K-M/ps5-wireless-headphones/hardware/README.md

# Hardware

Printable STLs and the editable Fusion 360 sources for both enclosures.

## Files

| Folder | Contents |
|---|---|
| [`stl/headset-modules/`](stl/headset-modules/) | One STL per part, plus `all-parts_plate.stl` (the original export, all parts laid out together) |
| [`stl/transmitter/`](stl/transmitter/) | `case.stl` and `lid.stl` for the Waveshare ESP32-S3-Pico, plus the combined plate |
| [`fusion/`](fusion/) | `headset-modules.f3d` and `transmitter.f3d`. Edit these to fit other headbands or boards. |

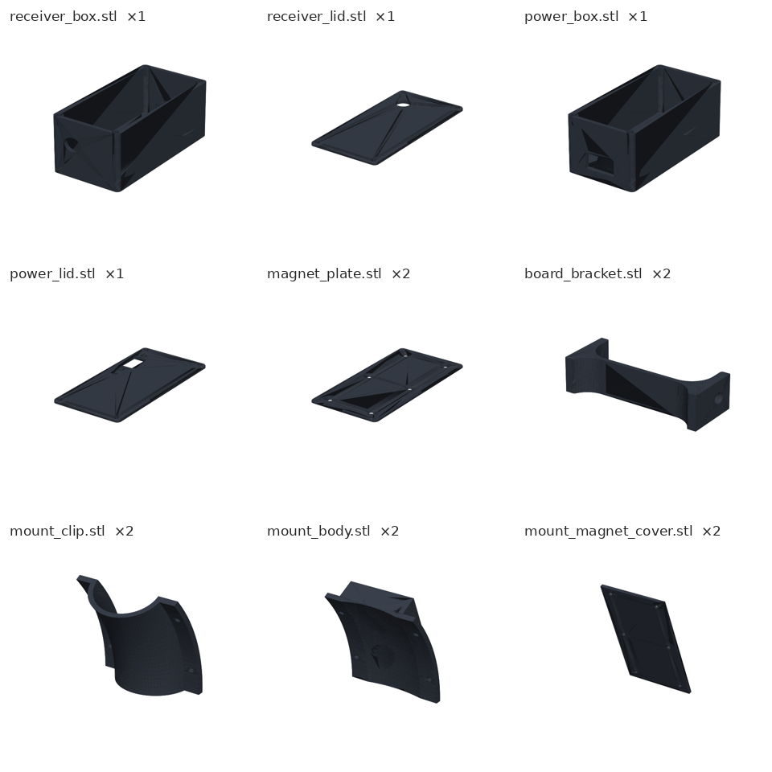
[picture p6: hardware/headset-parts.png]
Headset module parts


| Part | Qty | Notes |
|---|---|---|
| `receiver_box` | 1 | Houses the ESP32-S3-Nano (the box with the round side hole) |
| `receiver_lid` | 1 | Lid with the encoder-knob hole |
| `power_box` | 1 | Houses the LiPo, HW-107, HW-106, switch and LED |
| `power_lid` | 1 | Lid with the slide-switch cutout |
| `magnet_plate` | 2 | One per box, 6 × M2 screws; it attaches the box to the headband mount |
| `board_bracket` | 2 | Holds the ESP32 and HW-106 boards in place by sitting in the pin-header grooves (neither board has mounting holes) |
| `mount_clip`, `mount_body`, `mount_magnet_cover` | 2 each | Curved headband mount, one per module (see below) |

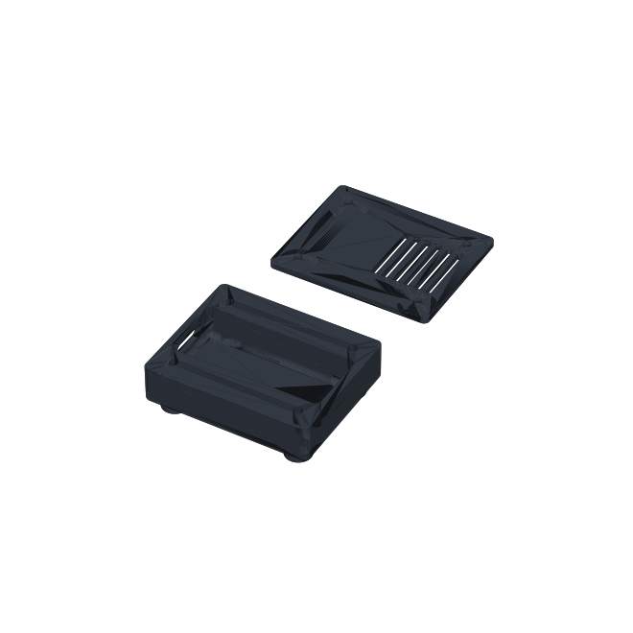
[picture p7: hardware/transmitter-parts.png]
Transmitter case and lid


Print in PLA or PETG at 0.2 mm layers. No supports are needed for the lids and plates. The boxes and the curved mount parts may need supports, depending on how you orient them.

## Layout

There are two printed boxes, one on each side of the headband. Each box sits on a curved mount that clips to the band and holds it by magnets.

| Module | Contents | Controls / ports |
|---|---|---|
| Power | LiPo, HW-107 charger, HW-106 boost, DPDT switch, LED, USB-C breakout | LED window, slide switch, USB-C (charging), 5 V out to the receiver |
| Receiver | ESP32-S3-Nano, rotary encoder, USB audio dongle | Volume knob, 3.5 mm out, USB |

Splitting the build like this balances the weight on the headband and keeps the boost converter away from the radio and audio parts.

| | | |
|---|---|---|
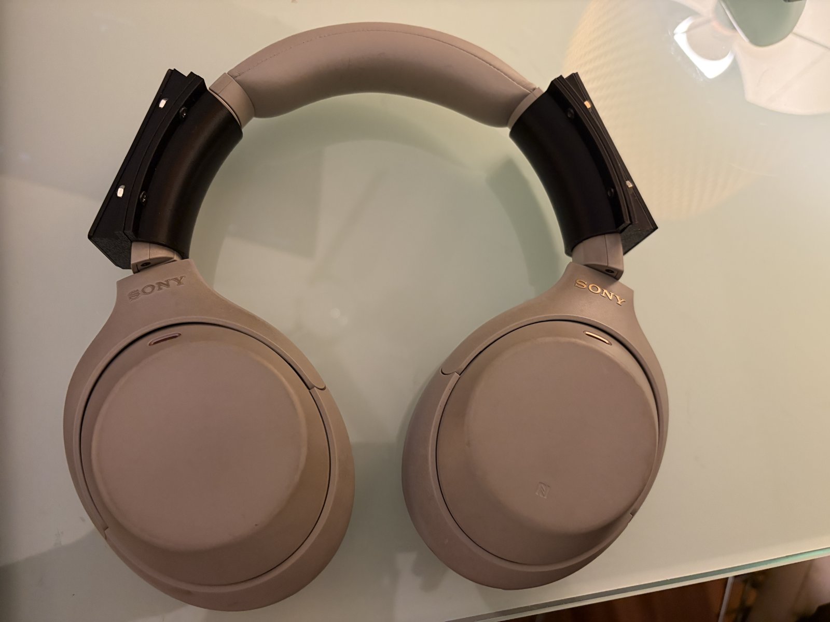
[picture p8: images/mounts-on-headband.jpg]
Curved mounts on the headband
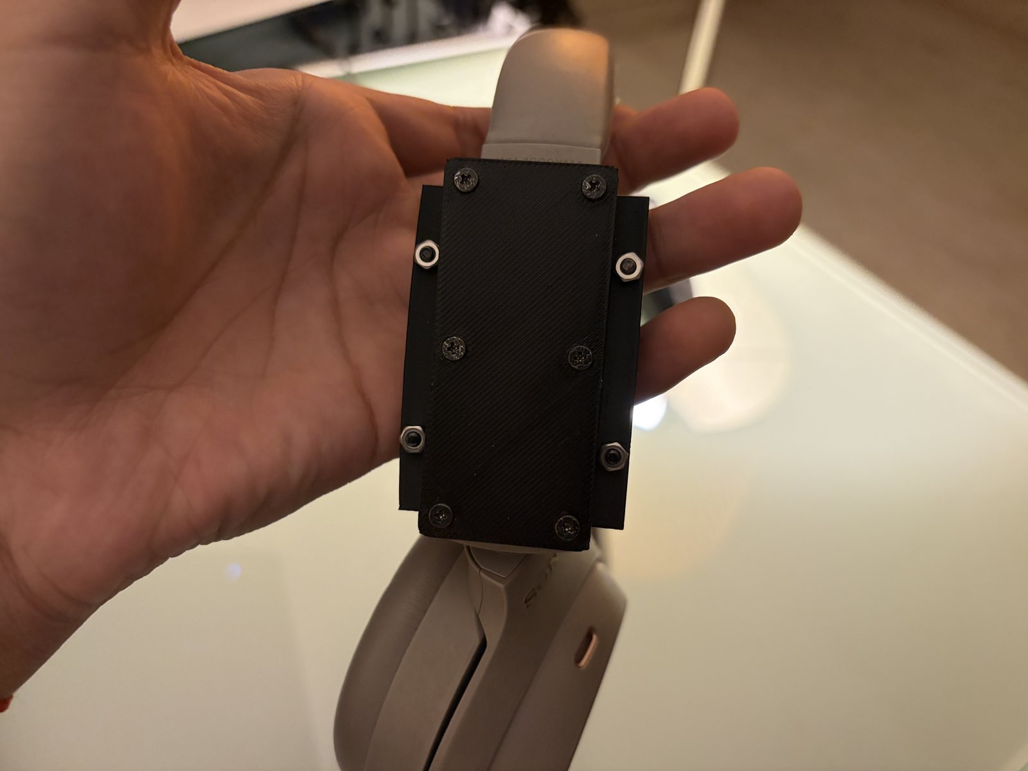
[picture p9: images/magnet-mount.jpg]
Magnet mount plate
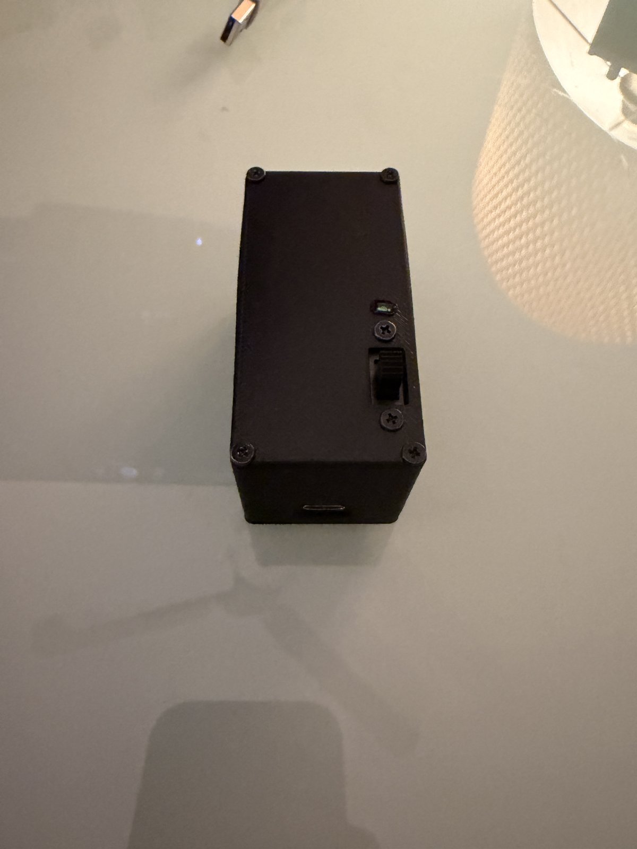
[picture p10: images/power-module-top.jpg]
Power module top: LED and switch
|  |  |  |
| Curved mounts, modules removed | Magnet mount plate | Power module: LED, switch, USB-C |
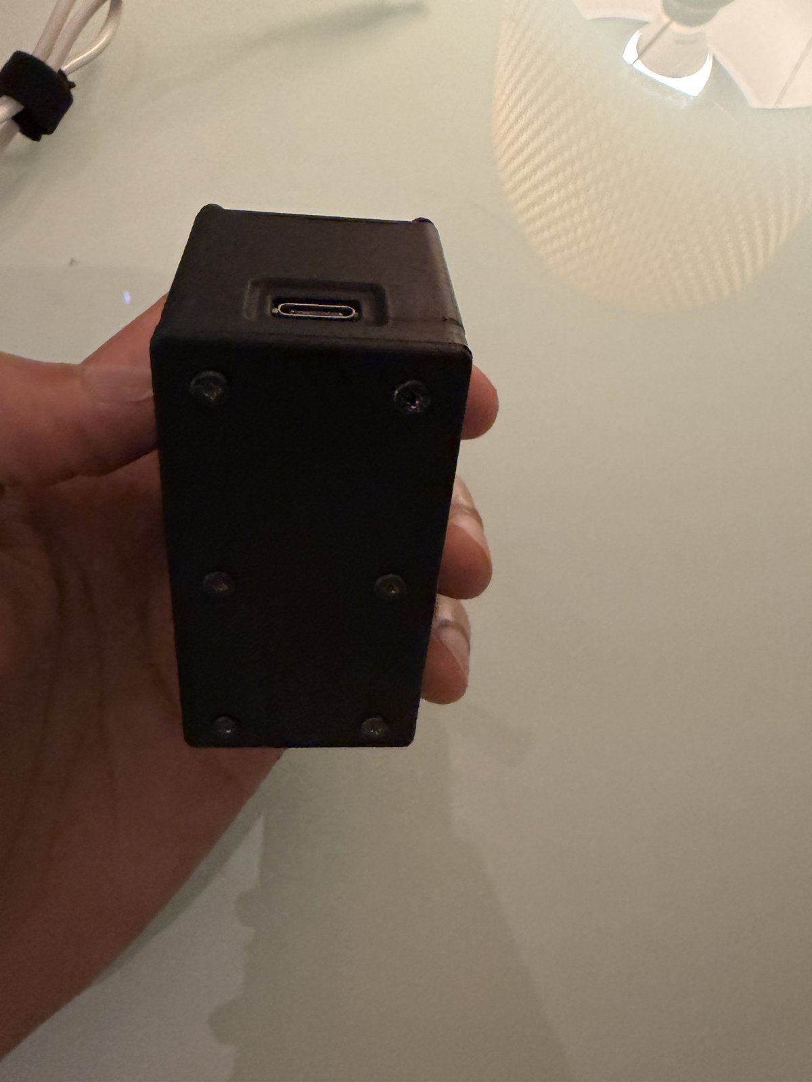
[picture p11: images/power-module-back.jpg]
Power module back
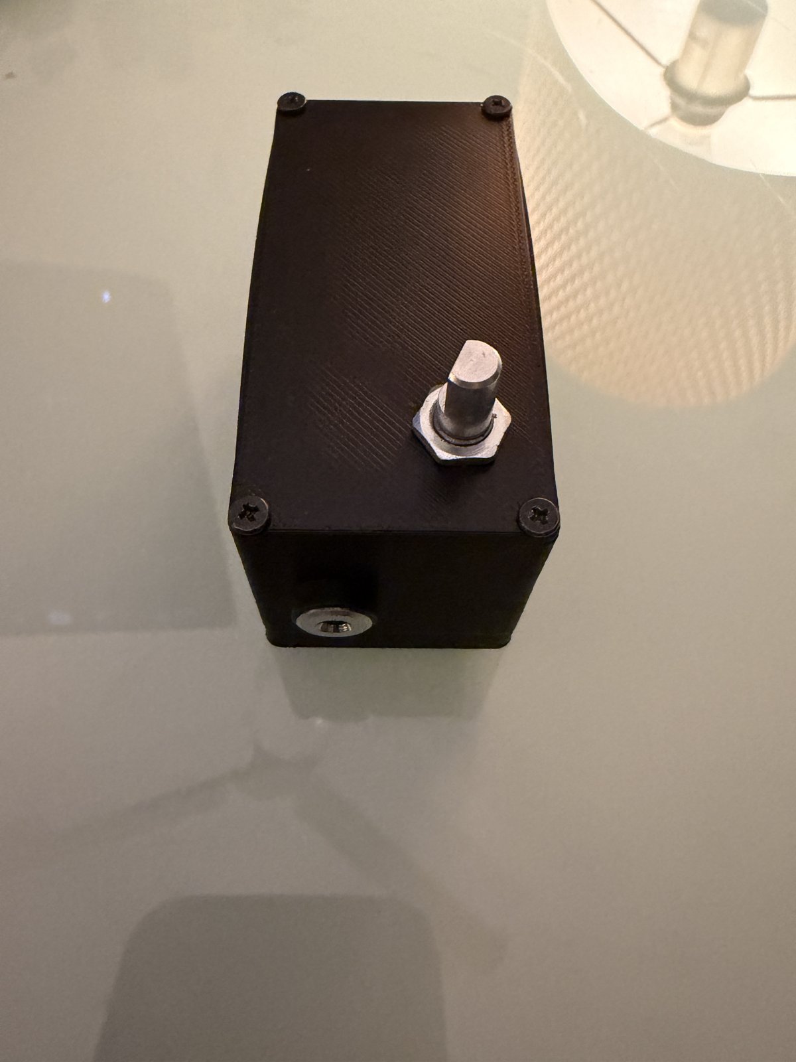
[picture p12: images/receiver-encoder-jack.jpg]
Receiver: knob and 3.5 mm jack
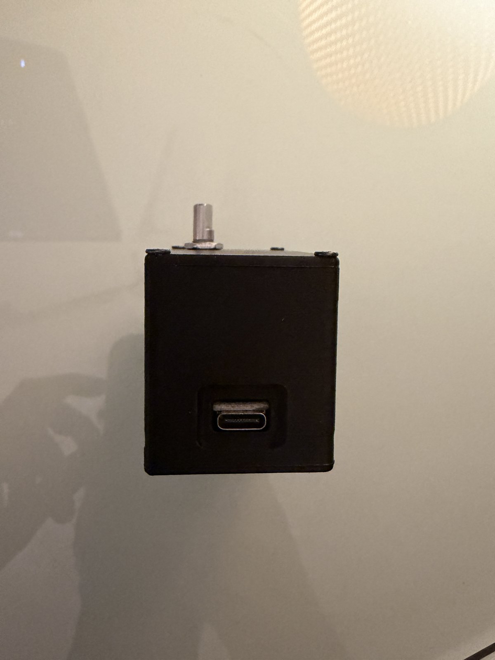
[picture p13: images/usb-c-end.jpg]
Module end with USB-C
|  |  |  |
| Power module lid, 6 × M2 screws | Receiver: volume knob and 3.5 mm | Module end, USB-C |

## Curved headband mount (Fusion 360)

The WH-1000XM4 headband's top surface has a radius of about **99.33 mm**. The mount is a 2D cross-section revolved around an axis at that radius:

1. Sketch the cross-section in the front plane: the magnet cover, the body, and the clip that wraps under the band.
2. Draw a horizontal construction line **99.33 mm below the top contact point**, outside every profile. If the axis touches a profile, Fusion reports that it "crosses the axis".
3. Revolve the profile around that line by **angle = length ÷ 99.33 × 57.3°**. For example, a 60 mm part needs 34.61°. Use the same angle for every part of the mount so they line up.

Revolve method

To measure your own headband's radius, trace its curve on paper. Then measure a chord *c* and the height *h* of the arc above the chord, and use **R = c²/(8h) + h/2**.

## Notes

- **Screws:** M2–M2.5 self-tapping into printed pilot holes. Use 1.6 mm pilot holes for M2 and 2.0 mm for M2.5.
- **Magnets:** keep them at least about 1 cm from the ESP32's antenna and the boost converter's inductor. If there's no room, use a thin steel plate as a shield behind the magnet.
- **Capacitors:** fit the 470 µF capacitor at the Nano's VBUS pin, not at the boost output. The boost and the Nano are in different modules, so the capacitor must sit at the load end of the cable.
