K-M/ps5-wireless-headphones/images/usb-a-end.jpg

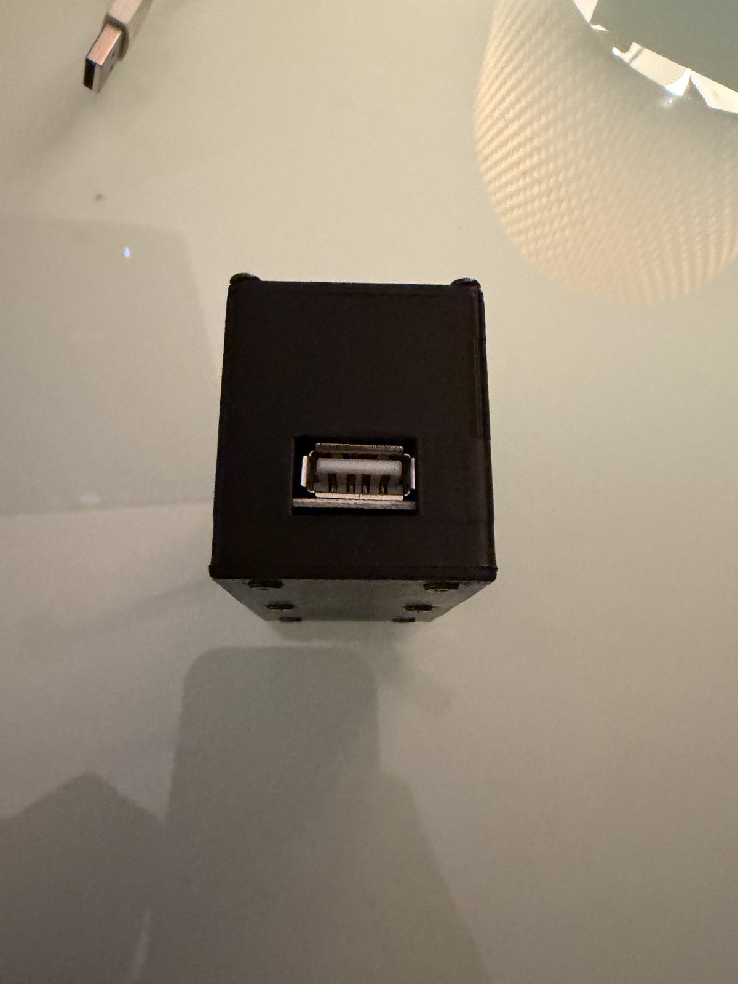
images/usb-a-end.jpg
