K-M/ps5-wireless-headphones/hardware/stl/headset-modules/mount_body.stl

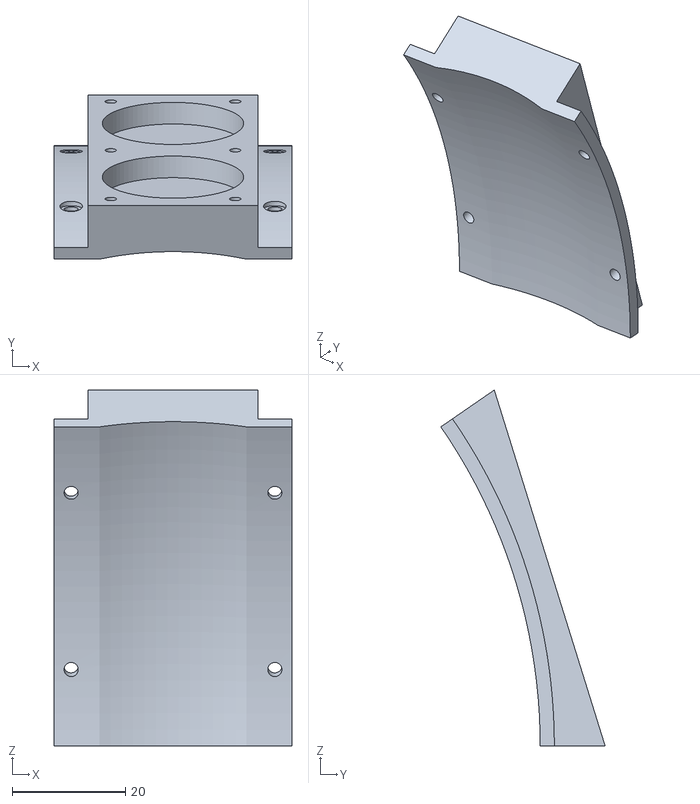
[picture p15: CAD file, 2026-10-23]
hardware/stl/headset-modules/mount_body.stl
42.0 x 29.0 x 62.9
