K-M/ps5-wireless-headphones/hardware/stl/transmitter/lid.stl

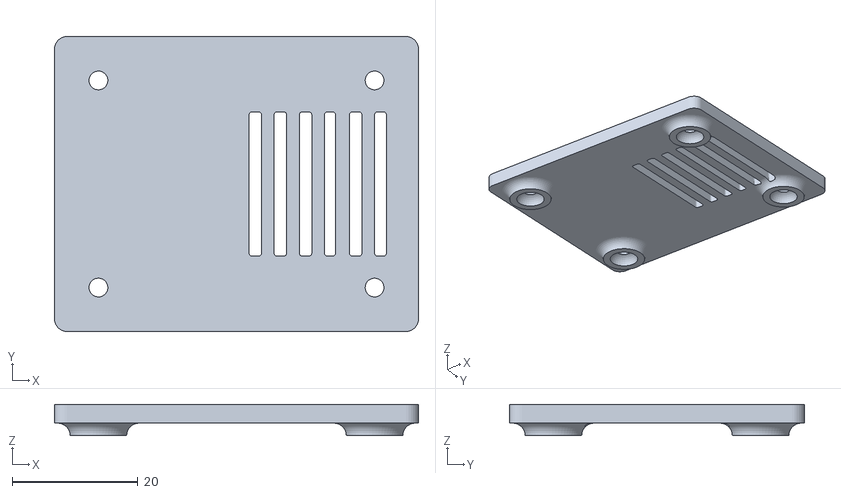
[picture p16: CAD file, 2026-10-23]
hardware/stl/transmitter/lid.stl
58.0 x 47.0 x 5.00
