K-M/ps5-wireless-headphones/hardware/stl/headset-modules/receiver_box.stl

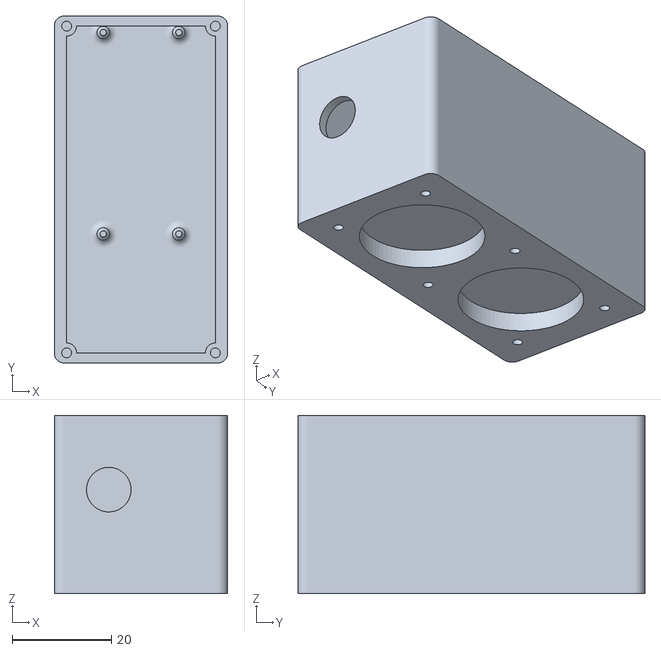
[picture p17: CAD file, 2026-10-23]
hardware/stl/headset-modules/receiver_box.stl
35.0 x 70.0 x 36.0
