K-M/ps5-wireless-headphones/hardware/stl/transmitter/case.stl

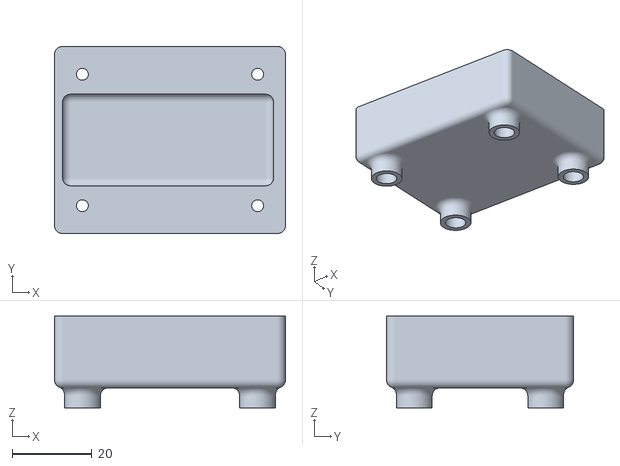
[picture p18: CAD file, 2026-10-23]
hardware/stl/transmitter/case.stl
58.0 x 47.0 x 23.0
