K-M/ps5-wireless-headphones/hardware/stl/headset-modules/mount_magnet_cover.stl

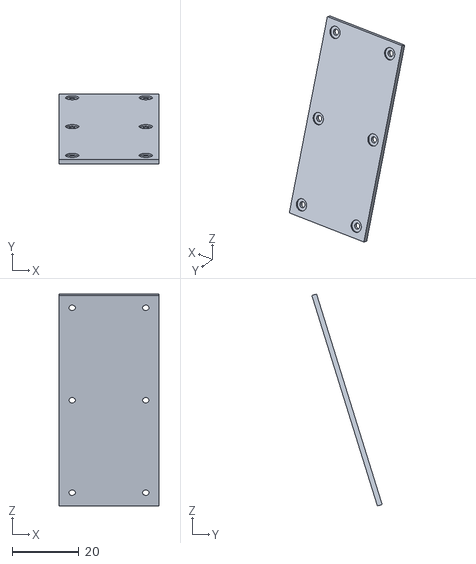
[picture p19: CAD file, 2026-10-23]
hardware/stl/headset-modules/mount_magnet_cover.stl
30.0 x 21.0 x 63.4
