K-M/ps5-wireless-headphones/hardware/stl/transmitter/all-parts_plate.stl

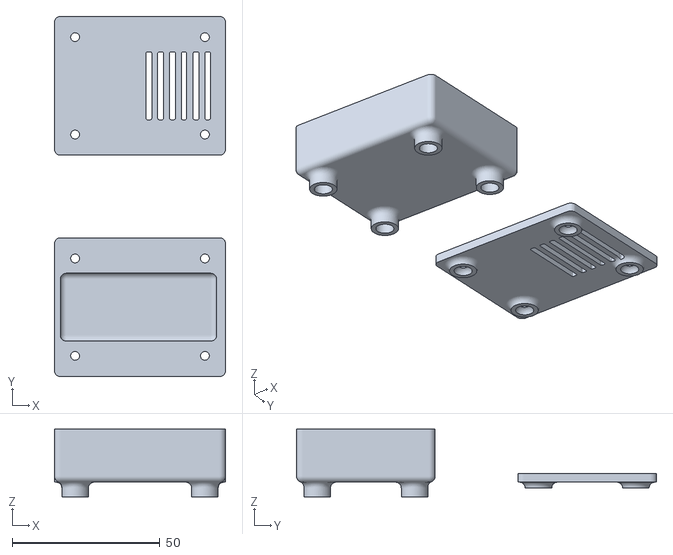
[picture p20: CAD file, 2026-10-23]
hardware/stl/transmitter/all-parts_plate.stl
58.0 x 122.0 x 23.0
