K-M/ps5-wireless-headphones/hardware/stl/headset-modules/all-parts_plate.stl

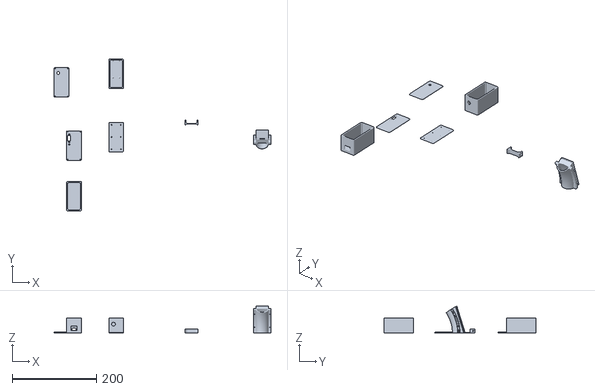
[picture p21: CAD file, 2026-10-23]
hardware/stl/headset-modules/all-parts_plate.stl
514.5 x 360.0 x 64.0
