K-M/ps5-wireless-headphones/hardware/stl/headset-modules/power_lid.stl

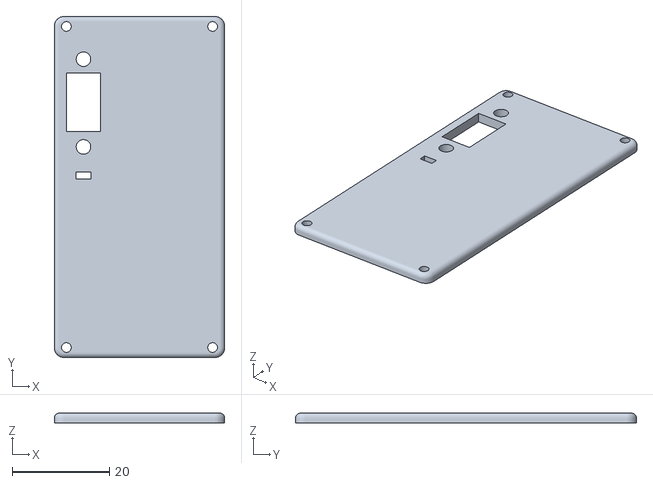
[picture p22: CAD file, 2026-10-23]
hardware/stl/headset-modules/power_lid.stl
35.0 x 70.0 x 2.00
