K-M/ps5-wireless-headphones/hardware/stl/headset-modules/board_bracket.stl

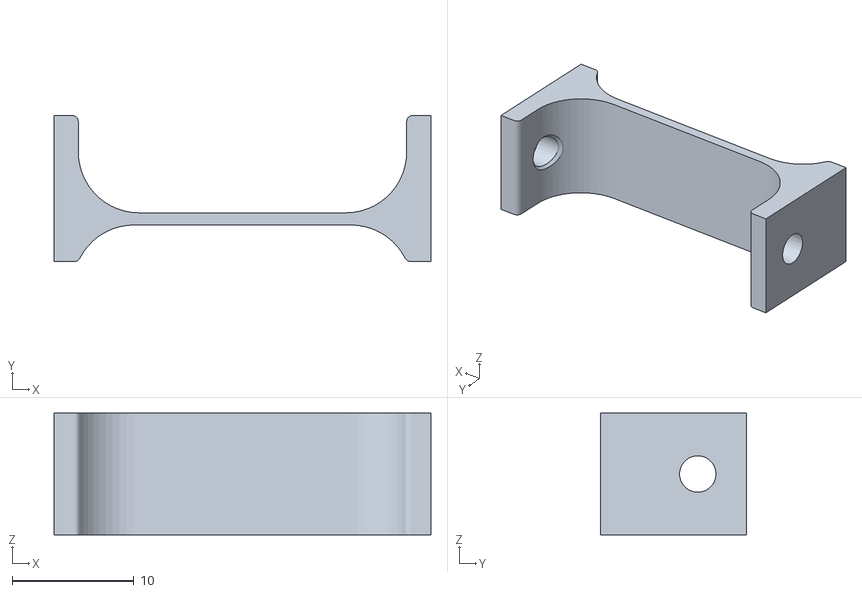
[picture p23: CAD file, 2026-10-23]
hardware/stl/headset-modules/board_bracket.stl
31.0 x 12.0 x 10.0
