K-M/ps5-wireless-headphones/hardware/stl/headset-modules/magnet_plate.stl

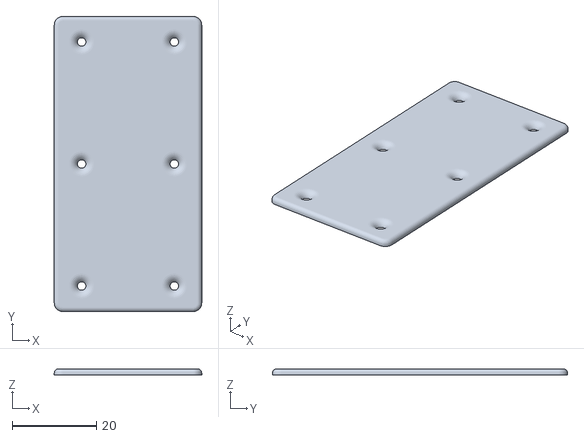
[picture p24: CAD file, 2026-10-23]
hardware/stl/headset-modules/magnet_plate.stl
35.0 x 70.0 x 1.50
