K-M/ps5-wireless-headphones/hardware/stl/headset-modules/mount_clip.stl

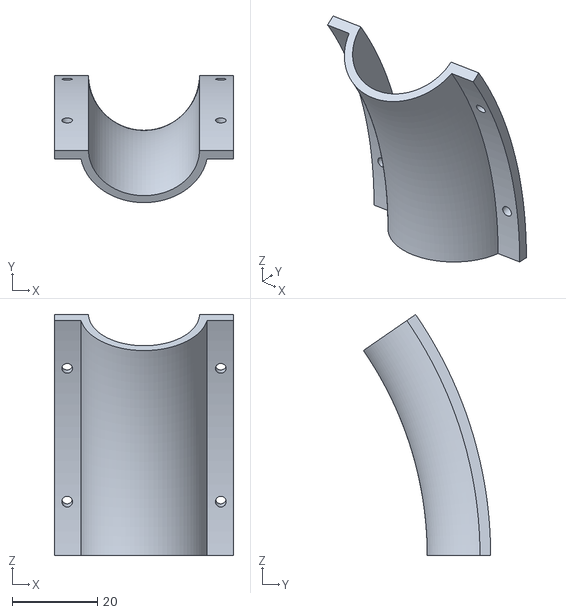
[picture p25: CAD file, 2026-10-23]
hardware/stl/headset-modules/mount_clip.stl
42.0 x 29.8 x 56.5
