K-M/ps5-wireless-headphones/(list of files, cad)

Other CAD files:
hardware/stl/headset-modules/receiver_lid.stl
hardware/stl/headset-modules/power_box.stl
hardware/fusion/headset-modules.f3d
hardware/fusion/transmitter.f3d
