K-M/ps5-wireless-headphones/(commit log)

2026-10-17 Initial release: PS5 wireless headphones over ESP-NOW
    [function.csv, library.csv, object.csv]
2026-10-23 Final hardware build: photos, encoder volume, power module docs
    - Add build photos (metadata stripped, resized to 1600 px)
    - README: two-module headband layout, HW-106/HW-107/DPDT/LED power
    module, encoder volume with +12 dB boost, compatibility, limitations
    - Firmware: encoder volume (v9 receiver), TX queue depth 1,
    experimental LINK_MIC behind a build flag
    - Web flasher images rebuilt for channels 1/6/11/13
    - hardware/: mount design (R 99.33 mm revolve method)
    - tools/latency/: end-to-end latency measurement kit
2026-10-23 Add enclosure STLs and Fusion 360 sources
    - hardware/stl/headset-modules: per-part STLs split from the print plate
    - hardware/stl/transmitter: case and lid for the ESP32-S3-Pico
    - hardware/fusion: editable .f3d sources
    - Parts preview renders and print notes
    [all-parts_plate.stl, base_6-screw.stl, box_1.stl, box_2.stl, bracket.stl, case.stl, headset-modules.f3d, lid.stl]
2026-10-23 Name enclosure parts and set print quantities
    [board_bracket.stl, magnet_plate.stl, mount_magnet_cover.stl, power_box.stl, power_lid.stl, receiver_box.stl, receiver_lid.stl]
